coreyfournier/SpookyEyeTracker/cad/led_insert.png

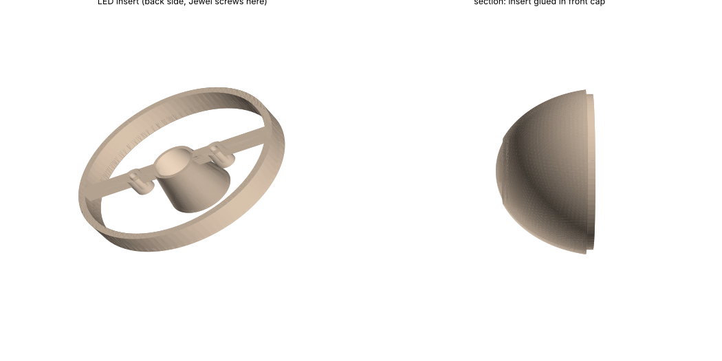
cad/led_insert.png
