coreyfournier/SpookyEyeTracker/cad/preview.png

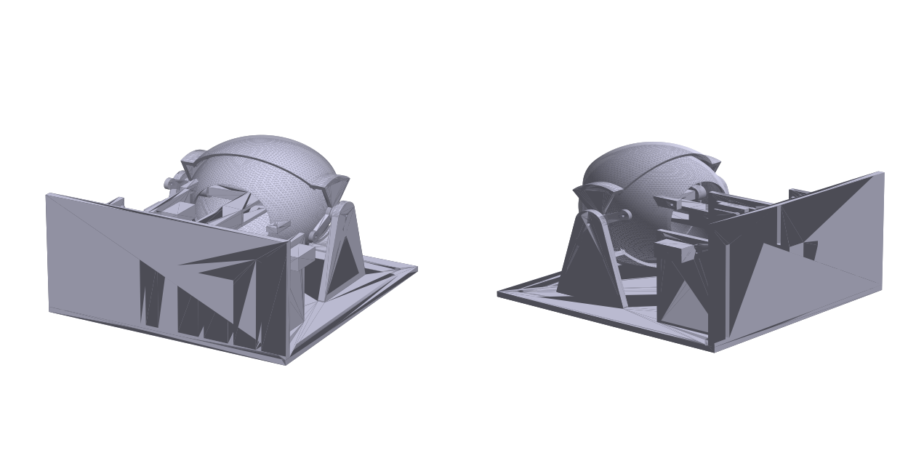
cad/preview.png
