coreyfournier/SpookyEyeTracker/docs/PRINTED_PARTS.md

# Printed eye and window mount

The eye is a 102 mm (4 in) hollow eyeball that glows from inside. It sits in a two-axis
gimbal (pan and tilt) between an upper and a lower eyelid, all moved by SG90 servos. A
lattice frame holds everything and hangs flat on the inside of a window from one suction
cup. Every part is generated by a Python script, so dimensions can be changed and the
STLs rebuilt.

[← Back to the overview](../README.md)

<p align="center">
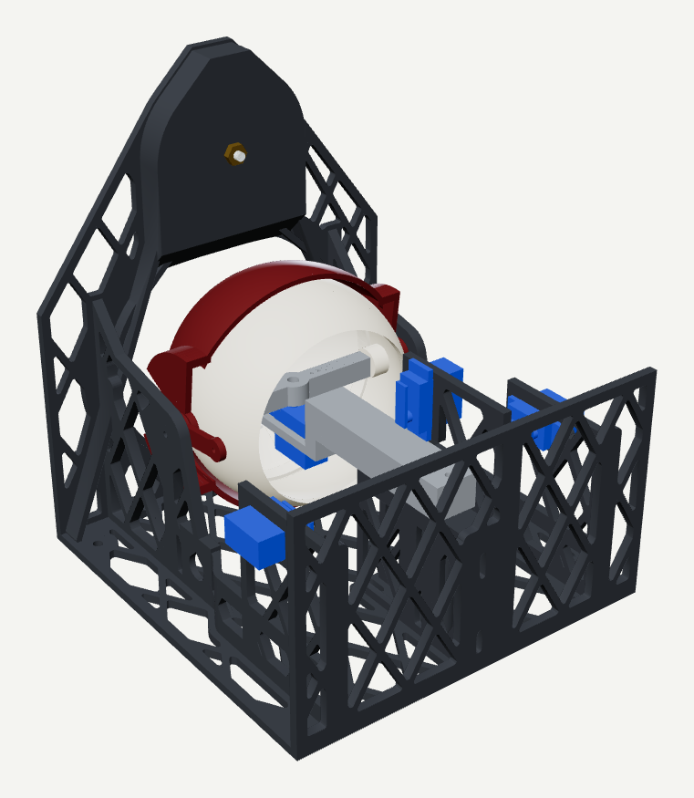
[picture p11: docs/images/cad-inside.png]
Assembled eye seen from inside the house: lattice frame, servos, gimbal
  
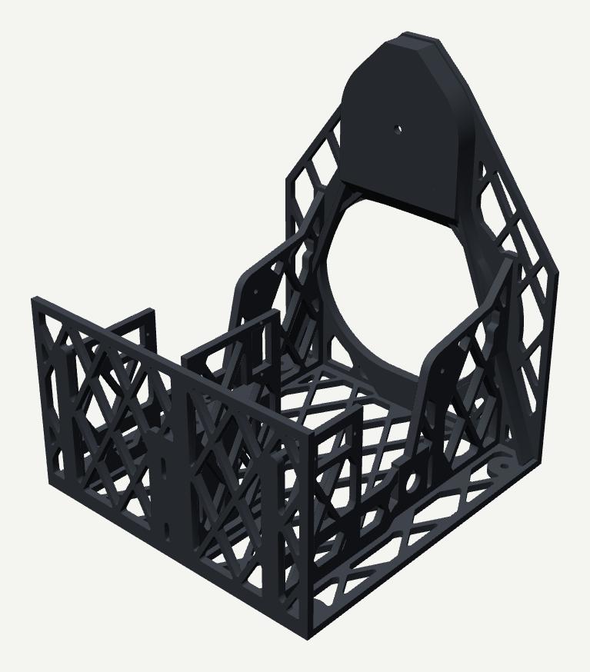
[picture p12: docs/images/cad-frame.png]
The frame on its own: window plate, cup pocket and lattice walls
  
</p>
<p align="center"><i>From inside the house: the eye in its gimbal, the four SG90 servos (blue) and the
lattice frame (left). The frame on its own (right).</i></p>

- [The parts](#the-parts)
- [Shopping list](#shopping-list)
- [How the eye lights up](#how-the-eye-lights-up)
- [How the eye moves](#how-the-eye-moves)
- [Printing](#printing)
- [Window mount](#window-mount)
- [Mounting the ESP32](#mounting-the-esp32)
- [USB-C power socket](#usb-c-power-socket)
- [Generating the STLs](#generating-the-stls)
- [Rendering](#rendering)

## The parts

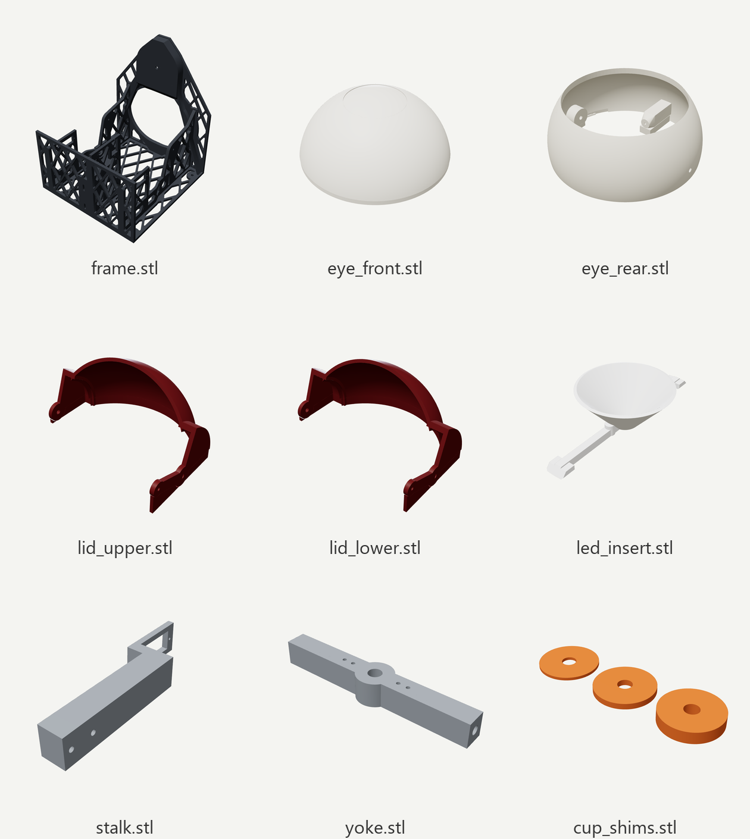
[picture p13: docs/images/cad-parts.png]
Every printed part, as it sits on the print bed


| File | What it is |
|---|---|
| `frame.stl` | Window plate, cup pocket, base tray, cradles for the tilt and lid servos, lid pivots, the stalk pedestal and the side rails the ESP32 mounts on, in one piece |
| `eye_front.stl` | Front of the eyeball: the glowing white and iris. Twist-locks onto the rear (bayonet with a click detent) |
| `eye_rear.stl` | Back of the eyeball: the side pivot bosses, the opening the stalk and tilt rod come in through, and the post inside that the tilt rod pulls on |
| `led_insert.stl` | Funnel that carries the jewel's centre LED to the iris and keeps the ring LEDs' light on the white. Twist-locks into the front of the eye |
| `lid_upper.stl`, `lid_lower.stl` | Eyelids, each with a lever arm for its servo pushrod |
| `yoke.stl` | Gimbal cross-piece: the eye pivots on its ends (tilt), and it sits on the pan servo's horn (pan) |
| `stalk.stl` | Arm from the frame's pedestal into the eye, with a cradle for the pan servo under the yoke |
| `cup_shims.stl` | Spacers (1, 2 and 4 mm) for the suction cup pocket, if needed |
| `*_nosupport.stl` | Versions of the eye halves and lids without the built-in snap-off supports |
| `ASSEMBLY_*.stl` | Everything in place, for checking (not for printing) |

## Shopping list

Per eye. Screw and pin sizes come from the hole sizes in `cad/build.py`. Lengths are
approximate, so check against your prints. Electronics are listed in
[FIRMWARE.md](FIRMWARE.md#shopping-list).

**Hardware**

| Qty | Part | Used for |
|----:|---|---|
| 1 | Large threaded suction cup, 8-32 stud with nut (e.g. UBL large threaded cup) | Hangs the frame on the window. Up to 2.68" / 68 mm across |
| 2 | 3 mm dowel pin, ~15 mm | Eye pitch pivots (press-fit through the eye's side bosses into the yoke) |
| 2 | Small screws from the servo's accessory bag (or M2 × 6 mm self-tapping) | Pan servo's double-arm horn to the yoke, through whichever pair of the yoke's holes line up |
| 1 | M2 ball link pair: ball stud + snap-on socket (RC car / plane linkage, for 1.5–2 mm rod) | Tilt rod to the post inside the eye. Screw the stud up into the post's 1.6 mm hole |
| 2 | M3 × 25-30 mm screws | Stalk (16 mm thick) to the frame pedestal (self-tapping into the printed holes) |
| 4 | M2 × 6-8 mm screws (or the servo's own) | Pan servo ears to the stalk's cradle (self-tapping) |
| 2 | M3 × 12 mm screws | Eyelid pivots: through each frame upright (self-tapping) into the lid's pivot hole |
| 2 | M2 / #2 × 6 mm (1/4") coarse-thread self-tapping screws for plastic (ST2.2, pan head) | LED jewel to the LED insert (1.6 mm pilot holes) |
| 3 | ~1.5 mm steel wire pushrods (or servo linkage kit) | Tilt servo horn to the ball link (~75 mm), and each lid servo horn to its lid's lever (2.2 mm holes, Z-bend the ends) |
| 4 | M4 screws | Optional: screw the frame down to a shelf instead of hanging it |
| 1 | [USB-C panel-mount pigtail](https://www.amazon.com/dp/B0D2M91MSJ) (listed with the electronics in [FIRMWARE.md](FIRMWARE.md#shopping-list)) | Power socket: through the 7/16 in hole in either side wall, nut inside |
| 4 | M2 or M2.5 screws with 5–8 mm standoffs and nuts | ESP32 board to the side rails (drill the holes to suit your board) |

**Filament**

| Part | Filament |
|---|---|
| `eye_front.stl` | White or translucent **regular** PLA. The whole front glows, and matte PLA blocks most light |
| `led_insert.stl` | White PLA (reflects the most light into the iris and the white of the eye) |
| Everything else | Any PLA. Matte is fine. A dark colour makes the frame disappear behind the glass |

Altogether it takes about 600 g: the frame is about 415 g, the eye parts about 170 g.

## How the eye lights up

The whole front of the eye glows, in two zones:

| Zone | Shell thickness | Lit by |
|---|---|---|
| Iris (40 mm circle) | 0.8 mm | The jewel's **centre LED**, carried out to the iris by the LED insert's funnel |
| White of the eye | 1.2 mm | The **six ring LEDs**, which sit outside the funnel |

The firmware drives them separately: the iris shows the state colour (idle / tracking /
sleep) and the white shows the `sclera` colour (see
[Firmware → behaviours](FIRMWARE.md#behaviours)). Paint a pupil on the iris if you want one.

## How the eye moves

The eye sits in a gimbal: it **tilts** on two pins through its sides into the yoke, and
the yoke **pans** about the vertical axis. Each axis is driven from a point the other axis
doesn't move, so pan and tilt never fight each other:

| Axis | Driven by | Why the other axis doesn't disturb it |
|---|---|---|
| Pan (±25°) | The pan servo, upright **inside** the eye on the stalk. The yoke sits straight on its horn | The yoke doesn't tilt, so tilting can't reach the pan servo. No pushrod |
| Tilt (±15°) | The tilt servo behind the eye. One pushrod goes in through the rear opening to a ball stud under a post inside the top of the eye | The ball is on the pan axis, so panning only spins it on its stud. The rod's length to it never changes |

The pan servo turns one-for-one with the eye (`us_per_deg` about 11). The tilt pushrod
gears the tilt about 2.4:1 on the horn's 8 mm hole (about 36° of servo for ±15° of eye,
`us_per_deg` about 27). `cad/build.py` checks every corner of the pan × tilt range for
collisions, including the rod, and that the rod's length doesn't change with pan.

**Assembling the gimbal:**

Before you start, break off all the snap-off supports. They're joined by a 0.2 mm air gap, so
pliers or a small screwdriver lever them off. Any you miss will stop the parts fitting:
- `eye_front`: the thin ring around the bayonet lip.
- `eye_rear`: a block under each side pivot boss, and a tall block under the tilt post at the
  top. All three stand right where the front's lip goes.
- The lids: the curtain under the front edge and the block under the lever.

1. Screw the pan servo into the stalk's cradle, shaft up. Screw a ball stud up into the
   post inside `eye_rear`, leaving the ball about 4–5 mm below the post.
2. Centre the pan servo (flash the firmware with the horn off: it goes to `center`), then
   press its double-arm horn on so the arms run left-right. Fit the yoke over the horn, put
   the horn's screw in through the yoke's centre hole, and fix the yoke to the horn with two
   small screws through the pair of yoke holes that line up.
3. Feed the stalk's back end out through the rear opening of `eye_rear` from the front, so
   the servo and yoke sit inside. Press the two pins through the eye's side bosses into the
   yoke ends.
4. Bolt the stalk to the frame's pedestal. Reach in through the rear opening to snap the tilt
   rod's ball link onto the ball. Z-bend the rod's other end into the tilt servo horn's 8 mm
   hole, with the horn pointing up and the eye looking straight ahead.
5. Twist-lock `eye_front` (with the LED insert) onto the rear. Route the servo and LED
   wires out through the rear opening along the stalk. The joint is a bayonet:
   - `eye_front` has a short lip (3.3 mm) standing out past its rim, with three small lugs on
     the outside.
   - `eye_rear` has a matching step inside its rim, 3.5 mm deep, with three notches in its wall
     that turn sideways at the bottom (L-shaped slots).
   - Line the lugs up with the notches and push the front straight in until the rims meet.
     Then, looking at the iris, turn the front 15° clockwise until it clicks. Counter-clockwise
     and pull takes it off.
   - Won't go in? Check all the snap-off supports above are off. If it's still tight, the first
     layer has probably spread (elephant's foot): shave the bottom edge of the lip and the
     mouth of the step with a hobby knife.

## Printing

**Eye parts.**
- `eye_front.stl` includes a snap-off support ring under its mating rim. Print it seam-face
  down and remove the ring afterwards. Turn on supports (build plate only, tree style) for
  the inside of the iris dome; they're reachable through the open back.
  `eye_front_nosupport.stl` is the same part without the ring, for slicer-generated supports.
- `led_insert.stl` prints back-face down with no supports (45° walls). If the iris and the
  white bleed into each other, paint the funnel's outside dark.

**Fitting the LED insert.** No glue needed: the insert twist-locks into the front of the eye.
1. Screw the jewel onto the insert first.
2. Hold the front of the eye open side towards you. Turn the insert so its long arm points
   about 30° clockwise from the two small shelves inside the wall (top and bottom).
3. Push it in until the funnel's rim touches the inside of the iris.
4. Twist it counter-clockwise. The arm ends ride up onto the shelves, click over a small
   bump, and stop against the end stops. The arm then points straight up and down, where the
   lids hide it.
5. To take it out, twist it back clockwise and pull.
- `eye_rear.stl` has snap-off blocks under its pivot bosses and under the tilt post. `yoke.stl`
  sits flat (the horn pocket underneath bridges 6.6 mm), and `stalk.stl` prints on its side.

**Eyelids.** Both lids print the same way up: standing on their pivot bosses, with the front
edge down and the shell leaning back over the pivot.
- That leaves the front edge 7.5 mm above the bed and the lever arm hanging, so each lid
  includes snap-off supports: a thin curtain under the front edge and a block under the lever.
  Each one stops a layer (0.2 mm) short of the lid, so print at 0.2 mm layers with **slicer
  supports off**, and snap them off afterwards.
- The inside of the shell leans back up to 70° near the top, which leaves it a little rough,
  but that side faces the eye.
- `lid_upper_nosupport.stl` and `lid_lower_nosupport.stl` are the same lids without the supports,
  for slicer-generated ones.

**Slicer warnings.** Bambu Studio and other slicers flag any spot that starts in mid-air as
"floating". The only part that should still ask for supports is `eye_front.stl`, for the inside of
the iris dome (see above). If any other part does, the STL is probably stale: rerun `build.py`.

**Frame.** To save filament and print time, every wall of the frame is a thin plate with
diamond lattice cut-outs. The plates stay solid wherever another part joins them, and
diagonal ribs carry the cup's pull down to the base corners. **Print it base-down at 100%
infill (or enough walls to fill 3-4 mm) with no supports.**
- The lattice diamonds have 60° sides, so they're self-supporting.
- The eye socket's walls flare at 60° from the gaze axis, which is 30° from vertical as the frame
  stands, so they need no support.
- The cup pocket has 45° shoulders up to a 20 mm flat top that bridges.
- The stiffening ring behind the socket has a 45° keel underneath, and its top runs into the
  cup pocket's chin.
- The cup pocket has a 45° chin underneath, so nothing starts in mid-air.
- In each side wall, a post runs from the lid pivot down to the base, and the wall's top edge
  rises steadily from the pivot to the front plate. Otherwise a lattice hole would end in a
  downward point and the wall above it would start in mid-air.
- The only other overhangs are short bridges (23 mm or less) across the tops of lattice
  holes and servo pockets, and where the side rails' top rail closes over the truss (16 mm or less).

The frame is 180 × 188 × 217 mm (W × D × H), so it needs a printer with at least 220 mm of
Z height.

## Window mount

`frame.stl` hangs the whole eye on the inside of a window. Its front plate sits flat
against the glass, with a flared socket the eye looks out through. Above the eye is a
pocket for one large threaded suction cup (up to 2.68" / 68 mm across, 8-32 stud):

1. Press the cup onto the glass where the eye should go.
2. Push the frame over it, so the cup sits in the pocket and its stud comes through the
   hole in the pocket floor.
3. Thread the nut on behind and snug it up. That pulls the frame flat against the glass,
   and the frame hangs plumb under the cup on its own.

The pocket is 14 mm deep, measured from the glass to the back of the cup's hub (`CUP_DEPTH`
in `cad/build.py`). Press one of your cups flat on a window and measure:
- **Hub sits shallower than 14 mm:** stack `cup_shims.stl` washers on the stud between the
  hub and the pocket floor.
- **Hub sits much deeper:** set `CUP_DEPTH` and rebuild.

The assembled eye weighs roughly 600-650 g with servos and electronics. One cup is rated
for 7 lb (3 kg). Because the weight hangs behind the glass, the cup carries the pull and
the bottom of the frame presses against the glass.

The eye's centre sits 60 mm behind the glass, so the eye and lids never touch it.

The socket is shaped like an eye socket, so people off to the side can still see the eye. Its
walls flare out toward the glass at 60°, and it's 16 mm wider than it is tall, because people
stand to the sides more than above or below. The cup pocket sits above it. At the glass it is
131 × 115 mm (W × H).

A stiffening ring sits behind the plate, just outside the socket's back edge. Nothing seen
through the socket can pass behind it, so the ring never hides the eye.

How much of the iris a person sees, with the eye turned toward them as far as it goes (±25°):

| Person stands off to the side by | 30° | 45° | 60° | 70° |
|---|---|---|---|---|
| Straight 80 mm hole (before) | 75% | 55% | 28% | 12% |
| Flared socket | 100% | 98% | 78% | 51% |

Beyond about 60°, the side walls that tie the front plate to the base hide the rest.

## Mounting the ESP32

Each side of the frame is one continuous wall. At the front, the gusset that ties the window
plate to the base stands in line with the lid pivot upright and merges with it. Behind the eye a
low truss, 28 mm high, carries it back to the lid servo cradle and the rear wall: two solid
8 mm rails, 20 mm apart centre to centre, with diagonal lattice between them. The uprights and
cradles aren't in line (4.5 mm apart on the right and 8 mm on the left), so the truss bends in a
smooth S just behind the eye. The wall does two jobs:
- **It stiffens the frame.** Without it, the front (cup) half and the rear (servo) half meet
  only through the thin base plate just behind the eye, which flexes like a hinge. The wall
  makes that joint about 130 times stiffer.
- **It holds the controller, inside the frame.** Between each wall's straight rear run and the
  edge of the base there's a bay 17 mm (left) to 20 mm (right) deep. Hold the board flat against
  the outside of the rails, mark its mounting holes and drill through. Any board whose two rows
  of holes are 13–27 mm apart lands on the rails, so this fits the Feather (17.8 mm), the HiLetgo
  OLED kit (about 21 mm) and most DevKit-style boards. The straight run is 75 mm long, so the
  board's length doesn't matter.

Use M2 or M2.5 screws with standoffs (5–8 mm) so the header pins and parts on the back of the
board clear the rails. A 51 × 26 mm board on 6 mm standoffs still sits inside the base's
footprint on either side, clear of the lid servos above it. The HiLetgo's OLED faces out to the
side, and its USB port stays reachable.

## USB-C power socket

Each side wall has a 7/16 in (11.1 mm) hole for a panel-mount (bulkhead) USB-C pigtail ([this one](https://www.amazon.com/dp/B0D2M91MSJ)), so
the 5 V supply can plug in from either side. The hole is low on the wall, 20 mm behind the eye's
centre and 14 mm above the base, in a solid pad that runs from the base to just above the top
rail. That puts it under the rear half of the eye, forward of all the servos: the eye's lowest
point and the lids' arms are well above it, and the closer the cable hangs to the window, the
less its weight levers the frame off the suction cup.

The wall is 5 mm thick there. A 20 mm counterbore on the inside face thins it to 3 mm
(`USB_PANEL`) for the nut. Check your connector's thread length and change `USB_PANEL` if
it needs more or less (5.0 removes the counterbore). Use the hole on one side and leave the
other empty, or fit a second connector there. Inside, run the pigtail back to the board in the
bay and split the 5 V there, as in [WIRING.md](WIRING.md#power).

## Generating the STLs

```powershell
.venv\Scripts\pip install trimesh manifold3d
.venv\Scripts\python cad\build.py
```

`cad/build.py` writes every part to `cad/stl/`, in its print orientation. It then checks the
assembly and prints the result: no part may overlap another, with the lids open or closed
and at every corner of the eye's pan (±25°) and tilt (±15°) range.

After changing a part, also run `.venv\Scripts\python cad\export_sim.py`. It writes the
assembled parts (eye-centre coordinates, lighter meshes) to `tracker/eyetracker/static/model/`
for the [eye simulator](TRACKER.md#eye-simulator).

Main settings at the top of each section of `build.py`:

| Setting | Default | What |
|---|---|---|
| `R_EYE` | 51 mm | Eyeball radius (102 mm eye) |
| `FRONT_WALL` | 1.2 mm | Thickness of the glowing white of the eye |
| `IRIS_R` | 20 mm | Iris radius |
| `LID_OPEN` | 45° | Eyelid travel |
| `JEWEL_HOLE_X` | 9.2 mm | Half the jewel's mounting-hole spacing. Measure yours |
| `Y_GLASS` | 60 mm | Glass plane, measured forward from the eye's centre |
| `VIEW_R` | 40 mm | Eye socket half-height, 10 mm behind the glass |
| `SOCKET_FLARE` | 60° | How far the socket's walls flare out toward the glass |
| `SOCKET_W` | 8 mm | How much wider than tall the socket is, each side |
| `CUP_POCKET_R` | 35 mm | Suction cup pocket radius (fits a 68 mm cup) |
| `CUP_DEPTH` | 14 mm | Glass to the back of the cup's hub |
| `CUP_Z` | 97 mm | Suction cup height above the eye's centre |
| `RIB`, `LATTICE` | 3 mm, 24 mm | Lattice rib width and spacing |
| `BASE_T` | 4 mm | Base and rear (servo) wall thickness |
| `USB_Y`, `USB_Z`, `USB_PANEL` | -20 mm, -56 mm, 3 mm | USB-C socket hole position (from the eye centre) and the wall thickness left for its nut |
| `RAIL_W`, `RAIL_PITCH` | 8 mm, 20 mm | Side wall rail height and centre-to-centre spacing (the ESP32 mount) |
| `RAIL_X` | right 67.5 → 63, left −71 → −63 | Side wall centre line at the servo cradle and at the lid upright (the S-bend joins them) |

## Rendering

The pictures in these docs come from:

```powershell
.venv\Scripts\pip install playwright pillow
.venv\Scripts\python cad\render.py
```

It builds the parts, places them as assembled (with a window pane and a suction cup for
context), and renders them with three.js in headless Edge. It writes
`docs/images/cad-*.png`. It needs an internet connection to load three.js. Rerun it after
changing the CAD.
