coreyfournier/SpookyEyeTracker/cad/stl/ASSEMBLY_with_servos.stl

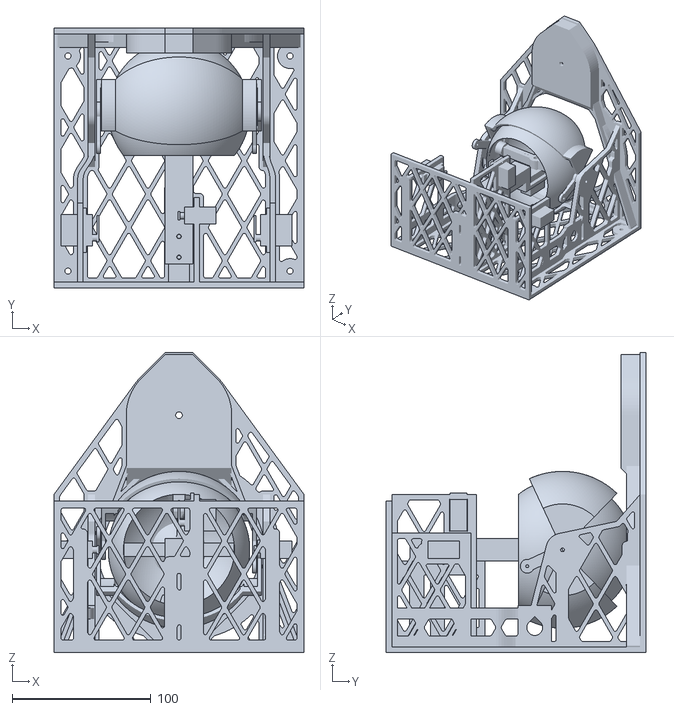
[picture p14: CAD file, 2026-11-04]
cad/stl/ASSEMBLY_with_servos.stl
180.0 x 187.0 x 216.2
