coreyfournier/SpookyEyeTracker/cad/stl/ASSEMBLY_preview.stl

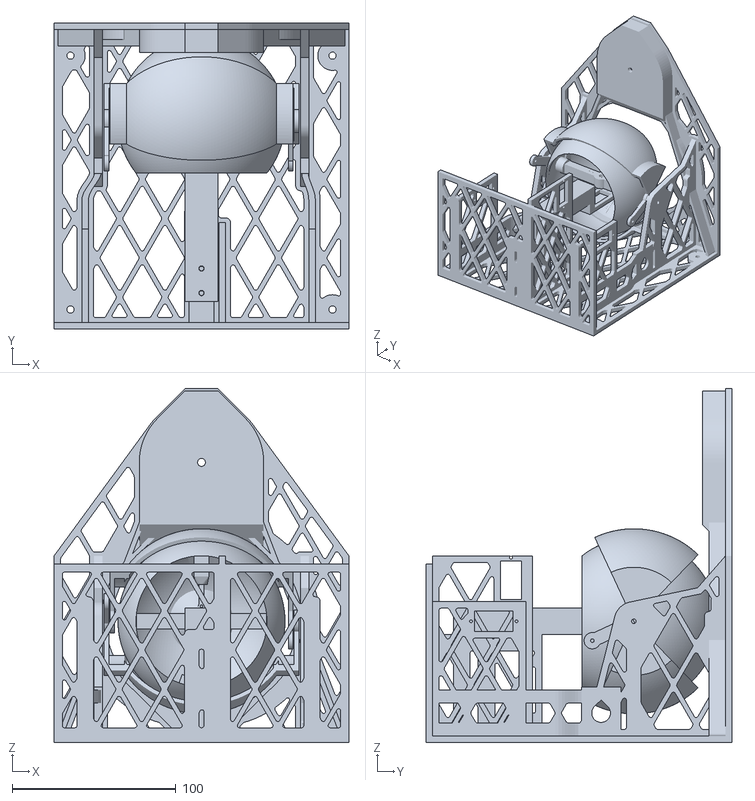
[picture p15: CAD file, 2026-11-04]
cad/stl/ASSEMBLY_preview.stl
180.0 x 187.0 x 216.2
