coreyfournier/SpookyEyeTracker/cad/stl/frame.stl

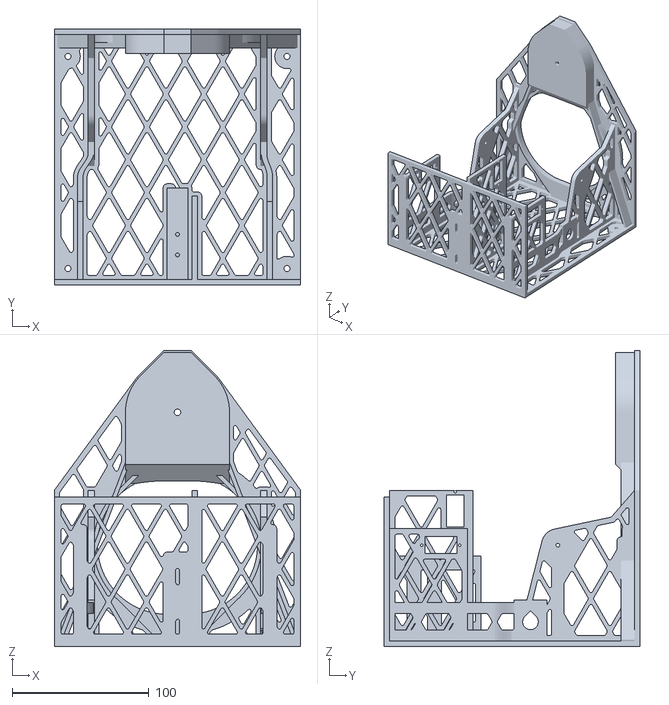
[picture p16: CAD file, 2026-11-04]
cad/stl/frame.stl
180.0 x 187.0 x 216.2
