coreyfournier/SpookyEyeTracker/tracker/eyetracker/static/model/servos.stl

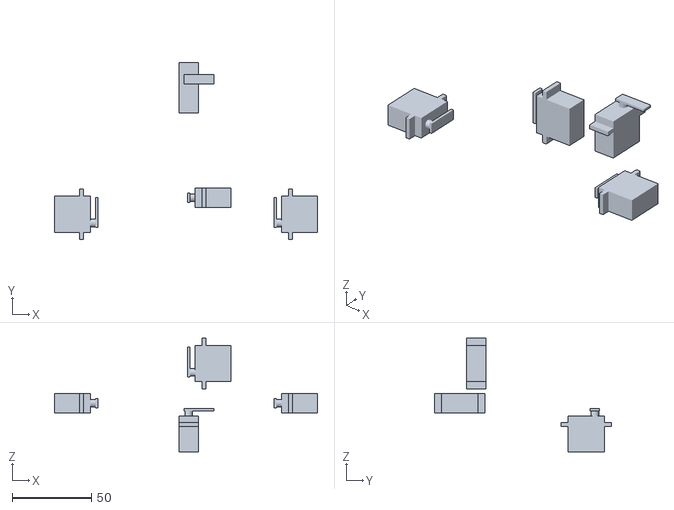
[picture p17: CAD file, 2026-11-03]
tracker/eyetracker/static/model/servos.stl
166.3 x 112.2 x 71.8
