coreyfournier/SpookyEyeTracker/tracker/eyetracker/static/model/eye_front.stl

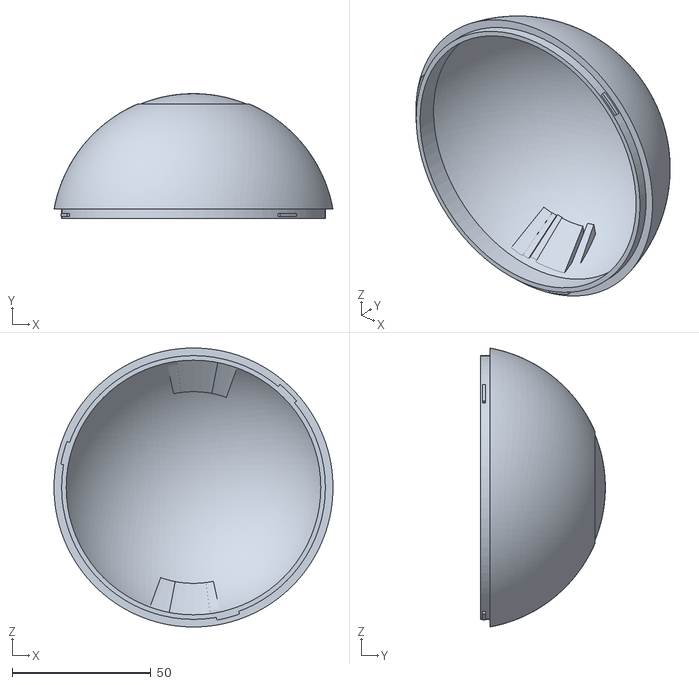
[picture p18: CAD file, 2026-11-03]
tracker/eyetracker/static/model/eye_front.stl
100.4 x 44.9 x 100.4
