coreyfournier/SpookyEyeTracker/cad/stl/lid_upper.stl

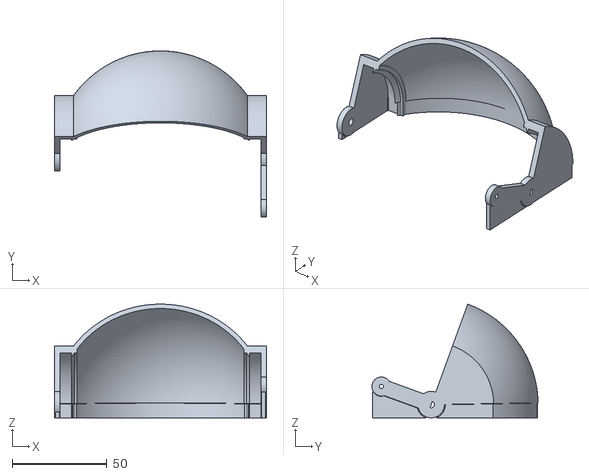
[picture p19: CAD file, 2026-11-04]
cad/stl/lid_upper.stl
112.0 x 87.8 x 60.1
