coreyfournier/SpookyEyeTracker/tracker/eyetracker/static/model/stalk.stl

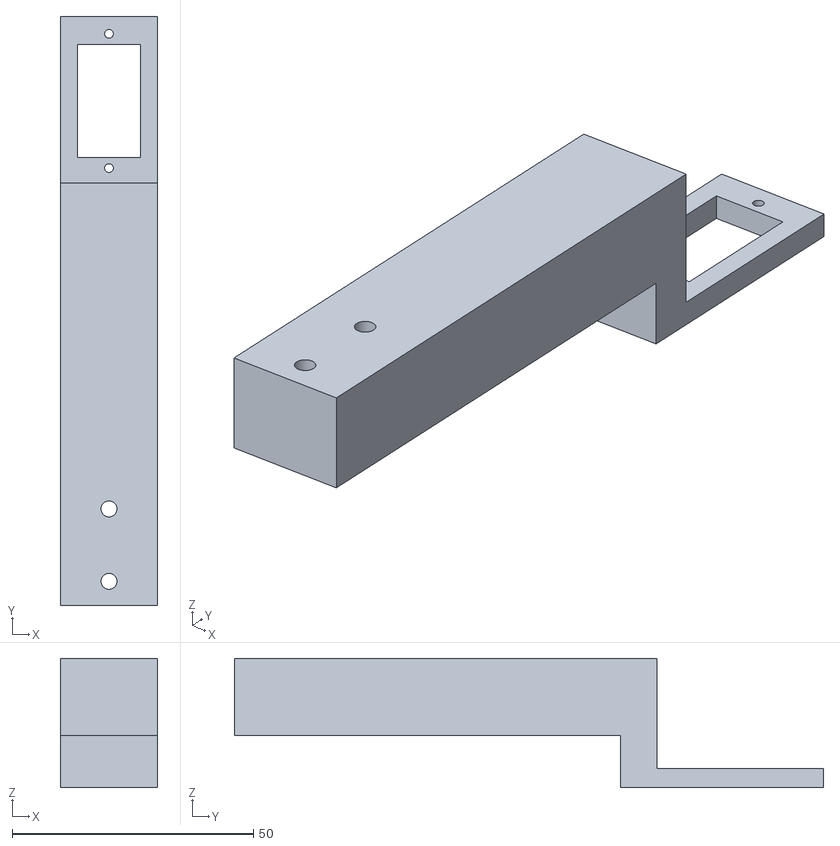
[picture p20: CAD file, 2026-11-03]
tracker/eyetracker/static/model/stalk.stl
20.0 x 122.0 x 26.8
