coreyfournier/SpookyEyeTracker/cad/stl/lid_lower.stl

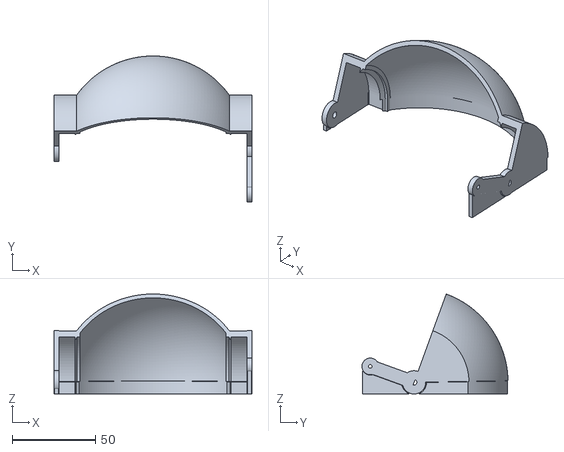
[picture p21: CAD file, 2026-11-04]
cad/stl/lid_lower.stl
119.0 x 87.8 x 60.1
