coreyfournier/SpookyEyeTracker/tracker/eyetracker/static/model/yoke.stl

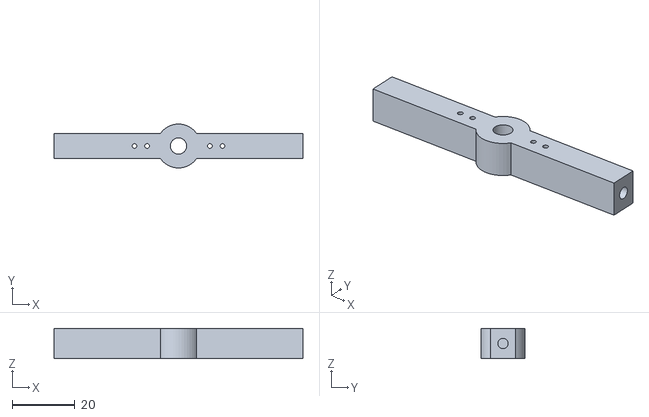
[picture p22: CAD file, 2026-11-03]
tracker/eyetracker/static/model/yoke.stl
79.2 x 14.0 x 9.60
