coreyfournier/SpookyEyeTracker/tracker/eyetracker/static/model/eye_rear.stl

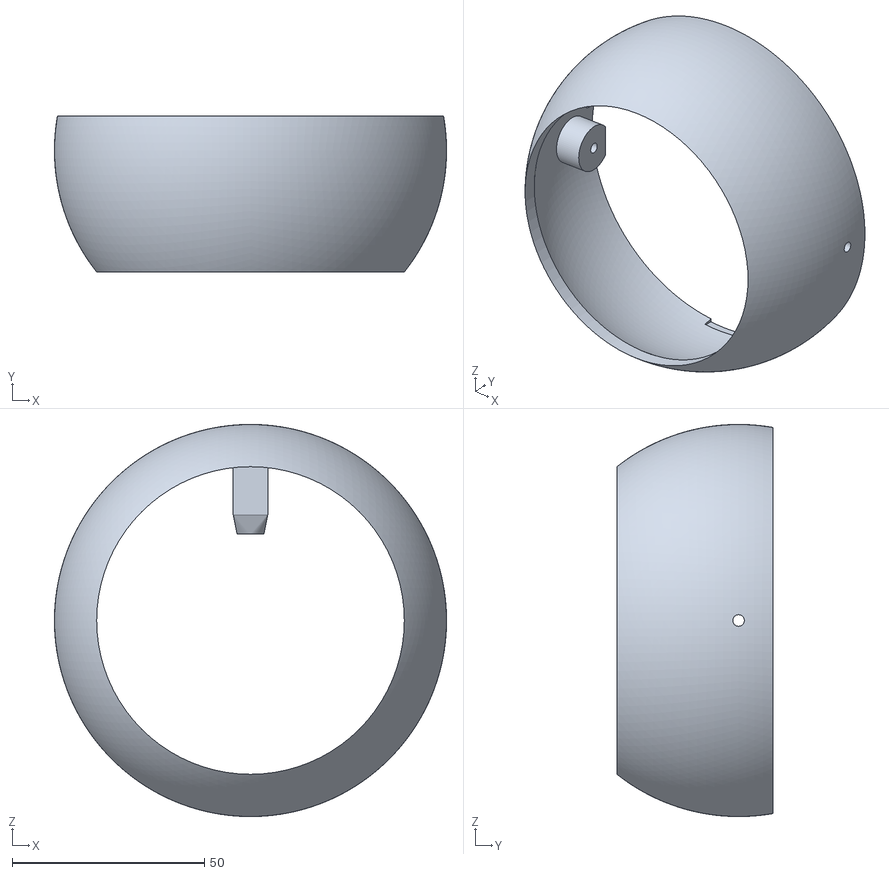
[picture p24: CAD file, 2026-11-03]
tracker/eyetracker/static/model/eye_rear.stl
101.9 x 40.7 x 102.0
