coreyfournier/SpookyEyeTracker/cad/stl/eye_front.stl

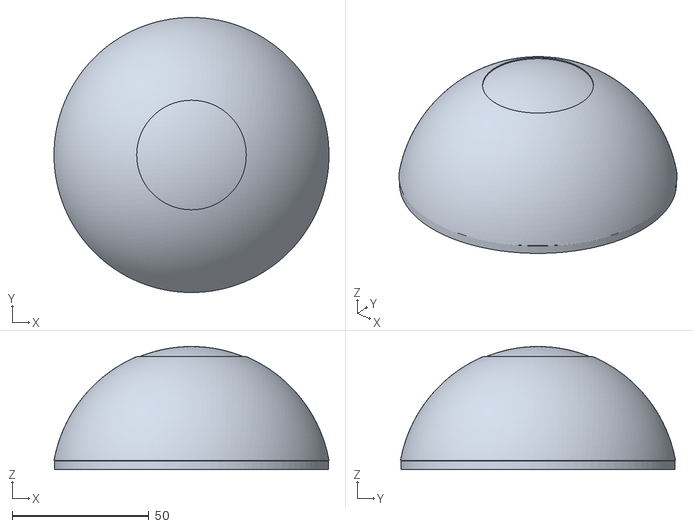
[picture p25: CAD file, 2026-11-03]
cad/stl/eye_front.stl
100.4 x 100.4 x 44.9
