coreyfournier/SpookyEyeTracker/tracker/eyetracker/static/model/lid_upper.stl

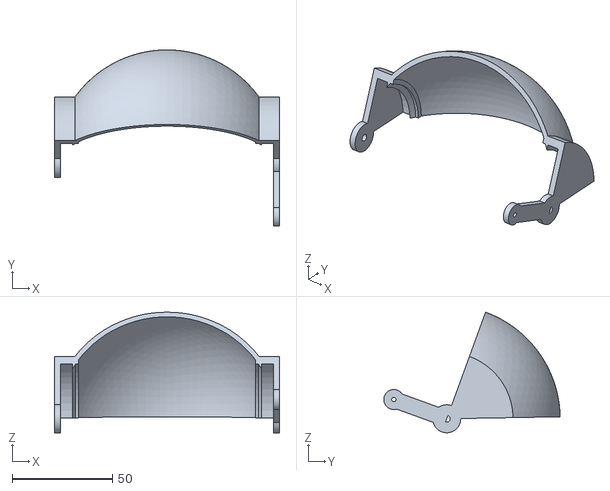
[picture p26: CAD file, 2026-11-03]
tracker/eyetracker/static/model/lid_upper.stl
112.0 x 87.8 x 60.1
