coreyfournier/SpookyEyeTracker/tracker/eyetracker/static/model/led_insert.stl

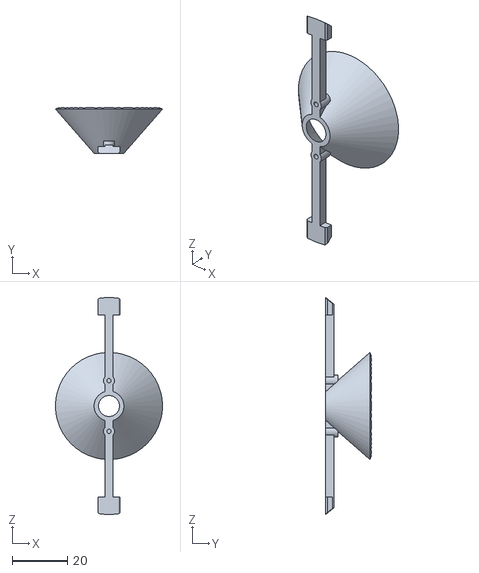
[picture p27: CAD file, 2026-11-03]
tracker/eyetracker/static/model/led_insert.stl
38.8 x 16.5 x 78.6
