coreyfournier/SpookyEyeTracker/cad/stl/eye_rear.stl

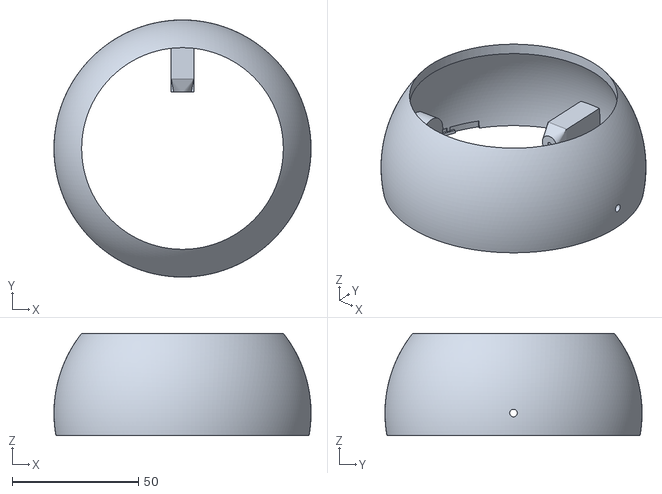
[picture p28: CAD file, 2026-11-03]
cad/stl/eye_rear.stl
102.0 x 102.0 x 40.7
