coreyfournier/SpookyEyeTracker/cad/stl/cup_shims.stl

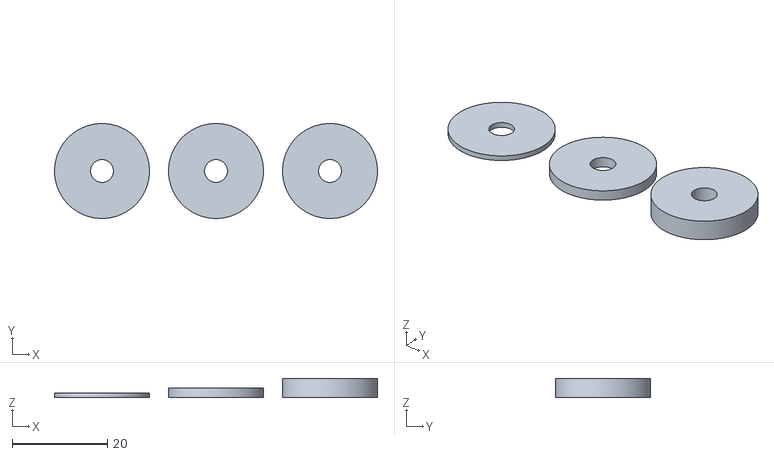
[picture p29: CAD file, 2026-11-01]
cad/stl/cup_shims.stl
68.0 x 20.0 x 4.00
