coreyfournier/SpookyEyeTracker/(list of files, cad)

Other CAD files:
tracker/eyetracker/static/model/frame.stl
cad/stl/eye_rear_nosupport.stl
tracker/eyetracker/static/model/lid_lower.stl
cad/stl/yoke.stl
cad/stl/eye_front_nosupport.stl
cad/stl/stalk.stl
cad/stl/led_insert.stl
cad/stl/lid_upper_nosupport.stl
