coreyfournier/SpookyEyeTracker/firmware/src/build_info.h

#pragma once
// Build-time identity. Normally set by platformio.ini (EYE_NAME) and scripts/version.py.
#ifndef EYE_NAME
#define EYE_NAME "eye"
#endif
#ifndef FW_VERSION
#define FW_VERSION "unknown"
#endif
#ifndef FW_BUILT
#define FW_BUILT ""
#endif
#ifndef FW_BOARD
#define FW_BOARD ""
#endif
