coreyfournier/SpookyEyeTracker/(commit log)

2026-11-01 Animatronic eye: person tracker, ESP32 firmware, CAD, Docker + CI
    - tracker: YOLO pose detection on 0-2 Hikvision cameras, world fusion with
    per-person eye-level height (mono + stereo triangulation), director that
    assigns people to eyes, UDP link to ESP32 eyes, web UI with phone
    calibrate-by-pointing
    - firmware: PlatformIO project for the HiLetgo ESP32 OLED kit (servos, WS2812
    jewel, OLED status, blink/wander/iris/spooky behaviors)
    - cad: build.py with the eye front lip bonded to the cap and a snap-off
    support ring under the mating rim
    - Dockerfile (CUDA and CPU variants), docker-compose, GitHub Actions running
    unit tests and a firmware compile before building and pushing to ghcr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
    [ASSEMBLY_preview.stl, ASSEMBLY_with_servos.stl, eye_front.stl, eye_front_nosupport.stl, eye_rear.stl, frame.stl, led_insert.stl, lid_lower.stl]
2026-11-01 cad: make the yoke and eye rear printable without mid-air layers
    - yoke arms are now as tall as the hub (+-4.8mm) so the part sits flat on
    the bed; previously both arms started 0.8mm above it
    - eye_rear.stl gets snap-off blocks under the pivot bosses, whose faces sat
    3.6mm above the bed over the bored-out lip socket
    - *_nosupport.stl variants kept for slicer-generated supports
    [ASSEMBLY_preview.stl, ASSEMBLY_with_servos.stl, eye_rear.stl, eye_rear_nosupport.stl, yoke.stl]
2026-11-01 Move aim calibration to the PC; keep servo mechanics on the eye
    Calibrate-by-pointing used to fold camera-pose errors into the eye's servo
    center/us_per_deg and push them to the ESP32. It now fits a per-eye `aim`
    correction (pan/tilt offset + scale) that lives only in the tracker config
    and is applied by the director before angles are sent:
    - no push or ack needed, so a fit takes effect immediately
    - the eye's firmware calibration stays purely mechanical, so idle wander,
    sleep and limits stay centred when the PC is offline
    - moving a camera only needs the aim reset/refit, not the eye's settings
    The calibration page now jogs in eye-space degrees (respecting the eye's
    limits) and adds Rese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
    [config.default.yaml]
2026-11-01 Show the eye's current activity on the OLED and in the UI
    The firmware reports a finer-grained activity than its state machine
    (track / hold / startle / wander / idle / sleep / manual). The OLED shows it
    large on the top line with the enabled behaviors on the bottom line, the
    status reply carries it as "act", and the web UI chips use it.
2026-11-01 Support the Adafruit HUZZAH32 ESP32 Feather as a second eye board
    - platformio.ini split into [heltec] and [feather] board sections; eye1 stays
    on the HiLetgo OLED kit, eye2 is the Feather (servo pins shared, LED data on
    GPIO 21 because GPIO 13 is the Feather's red LED)
    - OLED is now optional (HAS_OLED); boards without one show status on a
    single LED (PIN_STATUS_LED) and every activity change is logged to serial
    - CI compiles every board env
    - eye2 added to the config template; wiring, README and shopping list updated
2026-11-01 Tag eye firmware with its version and flag out-of-date eyes in the UI
    - firmware/scripts/version.py stamps each build with the last commit that
    touched firmware/ (+ "-dirty"), the build date and the board; the eye
    reports them in its status reply, logs them at boot and shows them on the
    OLED boot splash
    - the tracker works out the latest firmware commit (git, or
    EYETRACKER_FIRMWARE_VERSION baked into the Docker image by CI) and marks
    each eye current / outdated / dirty / unknown on the eye cards and header
    - Dockerfile sets the version last so firmware commits keep the PyTorch
    layers cached
2026-11-01 Light the whole eye: centre LED -> iris, ring LEDs -> white of the eye
    CAD:
    - the white of the eye (front cap outside the iris, above the bayonet
    collar) is thinned from 2.5mm to 1.2mm so the ring LEDs glow through it;
    the iris window stays 0.8mm
    - the LED insert's iris tube + pupil cone is replaced by an iris funnel
    that carries the centre LED out to the iris and keeps the six ring LEDs
    outside it; the jewel sits deeper (LED face y=28) so the funnel walls are
    45 deg and the insert prints without supports
    Firmware/config: LED 0 shows the iris colour by state, LEDs 1-6 show a new
    `sclera` colour (replaces the unused black `pupil`).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
    [ASSEMBLY_preview.stl, ASSEMBLY_with_servos.stl, eye_front.stl, eye_front_nosupport.stl, led_insert.stl]
2026-11-01 Add over-the-air firmware updates
    - firmware: password-protected HTTP update endpoint (POST /update, Basic
    auth eye:EYE_OTA_PASSWORD), rejects images for the other board type,
    pauses behaviour and shows progress on the OLED / status LED, reboots
    into the new image; disabled when built without a password
    - EYE_OTA_PASSWORD comes from the environment or .env at build time
    - pio envs eye1_ota / eye2_ota upload over WiFi (IP from the running
    tracker or --upload-port); default_envs keeps CI to the USB builds
    - tracker: stdlib-only ota module shared with the upload script,
    POST /api/eyes/{id}/firmware, and an "Update firmware..." button per eye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
    [build_info.h, main.cpp, ota.cpp, ota.h]
2026-11-01 Add Identify mode to find which physical eye you're configuring
    The eye lights all LEDs in one pulsing colour (per-eye identify_color,
    default cyan / magenta / ...), centres with lids open and suspends tracking,
    wander and blink; manual control still works. The OLED shows IDENTIFY and
    the Feather's LED blinks at 1 Hz. Toggle on each eye card and on the phone
    calibration page; it times out after 60 s unless the UI keeps it alive, and
    is switched off when the page closes.
2026-11-01 Camera calibration wizard: walk the yard from your phone, solve camera poses
    /camcal guides one person through six spots with spoken instructions. At each
    spot it waits for them to stand still, records ~2 s of face and feet pixels per
    camera, then sends them on. Solve fits every camera's position, heading, pitch,
    roll and FOV plus each spot's position (least squares, soft priors on the old
    poses, first spot optionally pinned to a measured position), reports how far
    apart the cameras placed you before/after, and Apply/Undo update config.yaml.
2026-11-01 Units option: show and enter distances in metres or feet
    A m | ft switch on every page saves ui.units (metric | imperial) in the config so
    all devices agree. units.js converts at the edges: yard map labels and grid,
    length fields in the eye/camera/settings forms (untouched fields keep their exact
    metric value), the eye-aim page, and the camera wizard (height accepts 5'9",
    spoken step distances in feet). config.yaml, the API and UDP stay metric.
2026-11-01 Add plain-language help (i) buttons to config fields
    help.js explains every non-obvious eye, camera and tracking setting: what it
    does and what raising or lowering it changes. Tapping (i) opens the text under
    the field, so it works on phones. Also fixes simpleCard binding Save to the
    first button in the card (now an (i) button) and shows feet to 2 decimals.
2026-11-01 Window mount: frame hangs on the glass from one suction cup, lattice-lightened
    The frame's front is now a plate that sits flush on the window with an arched
    view opening, rising to a pocket for a large 8-32 threaded suction cup (stud
    through the pocket floor, nut behind). Base, rear servo wall, front plate,
    gussets, servo cradles, lid uprights and the (now hollow) stalk pedestal get
    60-degree diamond lattice cut-outs, solid wherever another part joins them,
    found from exact cross-sections. Holes in upright walls are 45-degree arches
    with a short bridged top and the cup pocket has a 45-degree chin, so the frame
    prints base-down without supports. 320 cm3, down from 444 for the old table
    frame.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
    [ASSEMBLY_preview.stl, ASSEMBLY_with_servos.stl, cup_shims.stl, frame.stl]
2026-11-01 Add CAD renderings to the README
    cad/render.py places the parts as assembled (plus a window pane and the
    suction cup), renders them with three.js in headless Edge via Playwright and
    writes docs/images/cad-*.png: street view through the glass, side view on the
    window, inside view with the servos, the frame alone, and a grid of every
    printed part on the bed.
2026-11-01 Split the README into an overview and three in-depth guides
    README.md is now the overview: what it is, renders, how the parts fit, what
    you need, a getting-started path and the repo layout. Details move to:
    - docs/TRACKER.md: PC setup, Docker, web UI tour, calibration, tests and CI
    - docs/FIRMWARE.md: ESP32 boards, electronics list, flashing, OTA, versions,
    OLED/LED, behaviours, config push and the UDP protocol
    - docs/PRINTED_PARTS.md: parts, hardware and filament, lighting, printing,
    window mount, build.py settings and rendering
    WIRING.md now links back to them.
2026-11-01 README: feature the live yard map on the overview
    Shows the real pre-calibration capture and explains what it reveals (one
    person seen as two, wrong eye height) and how the camera wizard fixes it.
2026-11-01 Eye front: thin the iris from the outside only so its rim prints onto the white
    The iris window was thinned from both sides, leaving its inner surface 0.4mm
    below the white's with only a 0.3mm sliver between them. Printed seam-down,
    the iris rim started in mid-air ~1mm inside the white and came out stringy.
    The inside of the cap is now one smooth sphere (FRONT_WALL); the iris is
    recessed 0.4mm from the outside, keeping the 0.8mm light window.
    [ASSEMBLY_preview.stl, ASSEMBLY_with_servos.stl, eye_front.stl, eye_front_nosupport.stl, eye_rear.stl, eye_rear_nosupport.stl, led_insert.stl]
2026-11-01 Parts list: jewel screws are coarse-thread self-tappers for plastic
2026-11-01 LED insert twist-locks into the eye front instead of being glued
    The insert's arm now reaches the cap wall and ends in chamfered pads. Two
    shelves inside the front cap (top and bottom, under the lids) give a lead-in
    ramp, a one-layer detent bump, a seat and an end stop; their 45 deg undersides
    grow from the wall so the cap still prints unsupported. build.py checks the
    locked fit and that the insert slides in at the unlocked angle.
    [ASSEMBLY_preview.stl, ASSEMBLY_with_servos.stl, eye_front.stl, eye_front_nosupport.stl, led_insert.stl]
2026-11-01 Separate brightness for the iris (centre LED) and the white (ring LEDs)
    iris.brightness now sets only the centre LED; the new iris.sclera_brightness
    sets the six ring LEDs. The firmware scales each colour itself instead of
    using the strip's single setBrightness(). Configs written before the split
    get sclera_brightness copied from brightness on load, so nothing changes
    until it's adjusted.
2026-11-01 UI: min/max for numeric settings, shown by each field and enforced on save
    FIELD_LIMITS (help.js, same keys as the help texts) gives the allowed range
    of each bounded setting: brightness 0-255, probabilities 0-1, servo pulses
    500-2500 us, angles, ports and so on. The form sets the inputs' min/max/step,
    shows the range next to the label (lengths in the chosen units), outlines an
    out-of-range value in red, and Save refuses it with a message.
2026-11-01 UI: URL follows navigation, accordion sections, colours save instantly
    - The hash names the tab, card and open section (#eyes/eye1/iris,
    #settings/tracking); refreshes and shared links land there, tabs are
    links and Back works between them.
    - Eye, camera and settings forms are split into collapsible sections, one
    open per card, with a summary of each section's colours and on/off state.
    firmware/behaviors are unwrapped so Motion, Blinking, Colours etc. are
    top-level sections; manual servo control is its own section.
    - Colours & brightness save and push on change (live while dragging a
    colour picker); other unsaved edits on the card are left alone.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
2026-11-02 Frame: side rails tie the front and rear halves and mount the ESP32
    The cup half and the servo half of the frame met only through the 4mm base
    plate just behind the eye (I ~300 mm4, a hinge). A low truss on each side -
    two solid 8mm rails 20mm apart with 60 deg lattice between, 28mm high -
    runs from the front gusset into the rear wall: ~130x stiffer there for 19g.
    The rails double as a drill-to-fit mount for any board whose hole rows are
    13-27mm apart (Feather, HiLetgo OLED kit, most DevKits). Bridges under the
    top rail are <= 16mm, so the frame still prints without supports.
    [ASSEMBLY_preview.stl, ASSEMBLY_with_servos.stl, frame.stl]
2026-11-02 Frame: side walls move inboard and join the lid uprights to the servo cradles
    The front gussets now stand in line with the lid pivot uprights and merge
    with them; the side truss runs back from there to the lid servo cradles,
    bending in a smooth S where the two aren't in line (4.5mm right, 8mm left).
    Each side is one continuous wall, as stiff as before, and the ESP32 boards
    mount recessed in the 17-20mm bays between the walls and the base edge.
    The front plate's diagonal ribs now foot on the base (they used to land on
    the outer gussets), and the lattice keeps a diamond round each lid pivot so
    the holes beneath it have 45 deg ceilings.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
    [ASSEMBLY_preview.stl, ASSEMBLY_with_servos.stl, frame.stl]
2026-11-03 Cameras: Hikvision, ONVIF, any RTSP URL or USB
    Each camera now has a type:
    - hikvision: the existing RTSP channel URL (old configs are upgraded to it)
    - onvif: asks the camera for its RTSP address on connect (WS-Security digest
    login with clock-offset correction, GetCapabilities/GetProfiles/
    GetStreamUri); profile by token or name, empty = highest resolution
    - rtsp: any stream URL, with {user} {password} {ip} filled from .env
    - usb: a webcam by index or device path, at a requested resolution
    Cameras can name their own username_env/password_env (e.g. a separate ONVIF
    user). The ONVIF client is stdlib-only (onvif.py), with WS-Discovery that
    ignores non-camera devices. New API: /api/onvif/d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
    [config.default.yaml]
2026-11-03 Eye simulator: the 3D eye moves and lights as the firmware would
    /sim loads the assembled parts (cad/export_sim.py) with three.js and runs a
    port of behavior.cpp. It mirrors what the tracker sends an eye (look, manual,
    identify, release, via the new /api/eyes/{id}/sent) or runs a demo where you
    place the person in the yard. Try-out switches, cutaway, part toggles and
    orbit controls. Each eye card embeds it and feeds it unsaved edits.
    [eye_front.stl, eye_rear.stl, frame.stl, led_insert.stl, lid_lower.stl, lid_upper.stl, servos.stl, stalk.stl]
2026-11-03 Gimbal: pan servo inside the eye, tilt rod to a ball on the pan axis
    Both pushrods used to pull on tabs on the eyeball, so each axis moved the
    other's linkage: panning needed the tilt rod up to 20 mm longer (it jammed)
    and tilting dragged the pan ~5 deg.
    - Pan: the servo sits upright inside the eye on the stalk; the yoke sits on
    its horn. No rod.
    - Tilt: one rod from a servo behind the eye, in through a larger rear
    opening (r40), to an M2 ball stud under a post inside the top of the eye.
    The ball is on the pan axis, so panning only spins it.
    - build.py checks every pan x tilt corner, rod and ball link included, and
    that the rod length doesn't change with pan.
    - Defaults: pan us_per_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
    [ASSEMBLY_preview.stl, ASSEMBLY_with_servos.stl, eye_front.stl, eye_front_nosupport.stl, eye_rear.stl, eye_rear_nosupport.stl, frame.stl, servos.stl]
2026-11-04 Frame: flared eye socket so people off to the side can see the eye
    The window plate's straight 80mm hole, 10mm deep, hid half the iris from 45 deg off to the
    side. The opening is now a socket whose walls flare out toward the glass at 60 deg (30 deg
    from vertical as printed, so no supports), stretched 8mm each side into a stadium. The
    stiffening ring behind the plate moves out past the socket's back edge, where it can't
    hide anything seen through the socket.
    Iris visible with the eye turned toward the viewer (30/45/60/70 deg off to the side):
    75/55/28/12% before, 100/98/78/51% now. The range and interference checks still pass.
    [ASSEMBLY_preview.stl, ASSEMBLY_with_servos.stl, frame.stl]
2026-11-04 Print without floating regions: lid supports, frame side walls
    Bambu Studio flagged parts that start in mid-air:
    - Lids: both stood on their pivot bosses with the front edge 7.5mm up and the lever tip
    hanging, and the lower lid was exported upside down. Both now print the same way up
    (lid_print) with built-in snap-off supports PRINT_GAP below the edge and the lever
    (lid_supports); *_nosupport versions are kept for slicer supports.
    - Frame side walls: the pivot diamond's bottom corner, and the V where the lid upright met
    the gusset edge, gave lattice holes downward-pointing tops. A post now runs from the
    diamond to the base, and the upright fills up to the gusset edge.
    Every printe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
    [ASSEMBLY_preview.stl, ASSEMBLY_with_servos.stl, frame.stl, lid_lower.stl, lid_lower_nosupport.stl, lid_upper.stl, lid_upper_nosupport.stl]
2026-11-04 Frame: USB-C power socket hole in each side wall
    A 7/16in hole for a panel-mount USB-C pigtail, low in each side wall under
    the rear half of the eye, forward of the servos so the cable hangs close to
    the window. Solid pad from the base, counterbore inside for the nut
    (USB_PANEL). Parts lists and wiring notes, including the 5.1k CC resistor.
    [ASSEMBLY_preview.stl, ASSEMBLY_with_servos.stl, frame.stl]
2026-11-08 Docs: how the eye halves twist-lock, and remove snap-off supports first
    The rear's support blocks stand where the front's bayonet lip goes, so list
    every snap-off support to break off before assembly, explain the bayonet,
    and add a fit tip for elephant's foot.
